GeorgeU04/Remote_Weather_Station/Servant_Remote_Station/Core/Src/main.c

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
/* Includes ------------------------------------------------------------------*/
#include "main.h"

/* USER CODE BEGIN Includes */
#include "../../SubGHz_Phy/App/app_subghz_phy.h"
#include "../../SubGHz_Phy/App/subghz_phy_app.h"
#include "BME280.h"
#include "stm32wlxx_hal.h"
#include <stdint.h>
#include <stdio.h>
/* USER CODE END Includes */


COM_InitTypeDef BspCOMInit;
RTC_HandleTypeDef hrtc;

SPI_HandleTypeDef hspi1;

SUBGHZ_HandleTypeDef hsubghz;

void SystemClock_Config(void);
static void MX_GPIO_Init(void);
static void MX_SPI1_Init(void);
static void MX_RTC_Init(void);
/* USER CODE BEGIN 0 */
struct BME280 sensor = {0};
const uint8_t NODE_ID = 0;
const uint32_t timeBetweenSendsMS = 5000U;
/* USER CODE END 0 */

/**
 * @brief  The application entry point.
 * @retval int
 */
int main(void) {

  /* USER CODE BEGIN 1 */
  struct weatherData data = {0};
  /* USER CODE END 1 */

  /* MCU Configuration--------------------------------------------------------*/

  /* Reset of all peripherals, Initializes the Flash interface and the */

  HAL_Init();

  /* Configure the system clock */
  SystemClock_Config();

  /* Initialize all configured peripherals */
  MX_GPIO_Init();
  MX_SPI1_Init();
  MX_SubGHz_Phy_Init();
  MX_RTC_Init();
  /* Initialize USER push-button, will be used to trigger an interrupt*/

  BSP_PB_Init(BUTTON_SW1, BUTTON_MODE_EXTI);
  BSP_PB_Init(BUTTON_SW2,

              BUTTON_MODE_EXTI);
  BSP_PB_Init(BUTTON_SW3, BUTTON_MODE_EXTI);

  BspCOMInit.BaudRate = 115200;
  BspCOMInit.WordLength = COM_WORDLENGTH_8B;
  BspCOMInit.StopBits = COM_STOPBITS_1;
  BspCOMInit.Parity = COM_PARITY_NONE;
  BspCOMInit.HwFlowCtl = COM_HWCONTROL_NONE;
  if (BSP_COM_Init(COM1, &BspCOMInit) != BSP_ERROR_NONE) {
    Error_Handler();
  }

  /* Infinite loop */
  /* USER CODE BEGIN WHILE */
  initBME280(&sensor, &hspi1, SPI1_CS_GPIO_Port, SPI1_CS_Pin);
  uint32_t lastSend = 0;
  while (1) {
    MX_SubGHz_Phy_Process();
    if (HAL_GetTick() - lastSend >= timeBetweenSendsMS) {
      lastSend = HAL_GetTick();
      if (!packetACKED) {
        sendWeatherData(&data, NODE_ID, &hrtc);
        printf("TX: sendWeatherData returned from no ACK\r\n");
      } else {
        readWeatherData(&sensor, &data);
        sendWeatherData(&data, NODE_ID, &hrtc);
        printf("TX: sendWeatherData returned\r\n");
      }
    }
    /* USER CODE END WHILE */
    MX_SubGHz_Phy_Process();

    /* USER CODE BEGIN 3 */
  }
  /* USER CODE END 3 */
}

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
void Error_Handler(void) {
  /* USER CODE BEGIN Error_Handler_Debug */
  /* User can add his own implementation to report the HAL error return state */
  __disable_irq();
  while (1) {
  }
  /* USER CODE END Error_Handler_Debug */
}
#ifdef USE_FULL_ASSERT

#endif /* USE_FULL_ASSERT */
