GeorgeU04/Remote_Weather_Station/Servant_Remote_Station/Servant_Remote_Station.ioc

Mcu.UserName=STM32WL55JCIx
PA11.Signal=SPI1_MISO
PA12.Signal=SPI1_MOSI
PA15.GPIO_Label=SPI1_CS
PA15.Signal=GPIO_Output
PA2.Signal=USART2_TX
PA3.Signal=USART2_RX
PB3.Signal=SPI1_SCK
PC14-OSC32_IN.GPIO_Label=RCC_OSC32_IN
PC14-OSC32_IN.Signal=RCC_OSC32_IN
PC15-OSC32_OUT.GPIO_Label=RCC_OSC32_OUT
PC15-OSC32_OUT.Signal=RCC_OSC32_OUT
PC3.GPIO_Label=FE_CTRL3
PC3.Signal=GPIO_Output
PC4.GPIO_Label=FE_CTRL1
PC4.Signal=GPIO_Output
PC5.GPIO_Label=FE_CTRL2
PC5.Signal=GPIO_Output
