GeorgeU04/Remote_Weather_Station/Master_Remote_Station/Core/Inc/main.h

#define RTC_N_PREDIV_S 10U
#define RTC_PREDIV_S ((1U << RTC_N_PREDIV_S) - 1U)
#define RTC_PREDIV_A ((1U << (15U - RTC_N_PREDIV_S)) - 1U)
#define RCC_OSC32_IN_Pin GPIO_PIN_14
#define RCC_OSC32_IN_GPIO_Port GPIOC
#define RCC_OSC32_OUT_Pin GPIO_PIN_15
#define RCC_OSC32_OUT_GPIO_Port GPIOC
#define FE_CTRL3_Pin GPIO_PIN_3
#define FE_CTRL3_GPIO_Port GPIOC
#define FE_CTRL2_Pin GPIO_PIN_5
#define FE_CTRL2_GPIO_Port GPIOC
#define FE_CTRL1_Pin GPIO_PIN_4
#define FE_CTRL1_GPIO_Port GPIOC
