GeorgeU04/Remote_Weather_Station/(commit log)

2026-06-01 Circular Database Implementation and UART Reading
2026-06-23 Page Size Bug Fix
    [main.c]
2026-06-26 Circuit Photos
