GeorgeU04/Remote_Weather_Station/(notices)

Notices in the files:
Servant_Remote_Station/SubGHz_Phy/App/subghz_phy_app.c:
Copyright (c) 2026 STMicroelectronics.
All rights reserved.
This software is licensed under terms that can be found in the LICENSE file
